wesleyv/Teensy-4.1-User-Configurable-Midi-to-CV/Midi to CV Schem and Production/Teensy 4.1 User Configurable Midi to CV.pdf

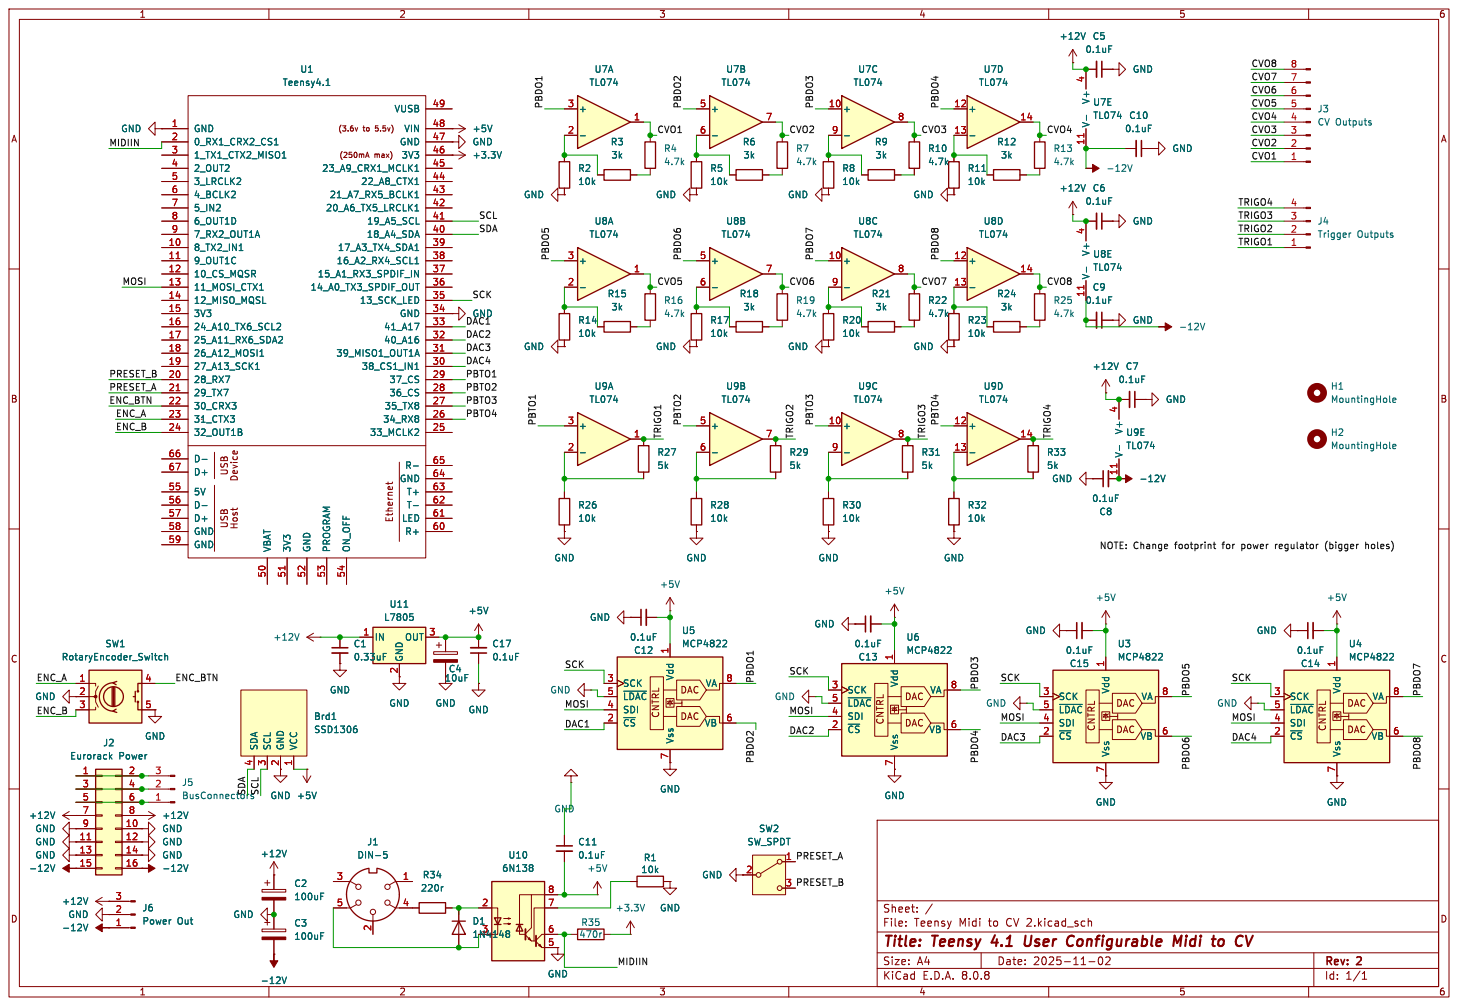
[picture p4: page 1]

1 ~{CS} 2 SCK 3 SDI 4 ~{LDAC} 5 VB 6 Vss 7 VA 8 U3 MCP4822 GND

1 ~{CS} 2 SCK 3 SDI 4 ~{LDAC} 5 VB 6 Vss 7 VA 8 U4 MCP4822 +

1 ~{CS} 2 SCK 3 SDI 4 ~{LDAC} 5 VB 6 Vss 7 VA 8 R30

1 ~{CS} 2 SCK 3 SDI 4 ~{LDAC} 5 VB 6 Vss 7 VA 8 U5 MCP4822 GND
0.1uFU10

1 ~{CS} 2 SCK 3 SDI 4 ~{LDAC} 5 VB 6 Vss 7 VA 8 GND

1 ~{CS} 2 SCK 3 SDI 4 ~{LDAC} 5 VB 6 Vss 7 VA 8 U6 MCP4822 C14
DAC Vdd

1 ~{CS} 2 SCK 3 SDI 4 ~{LDAC} 5 VB 6 Vss 7 VA 8 C14
