wesleyv/Teensy-4.1-User-Configurable-Midi-to-CV/Integrated Quad Slew Rate Limiter/Quad Slew Rate Limiter Schematic.pdf

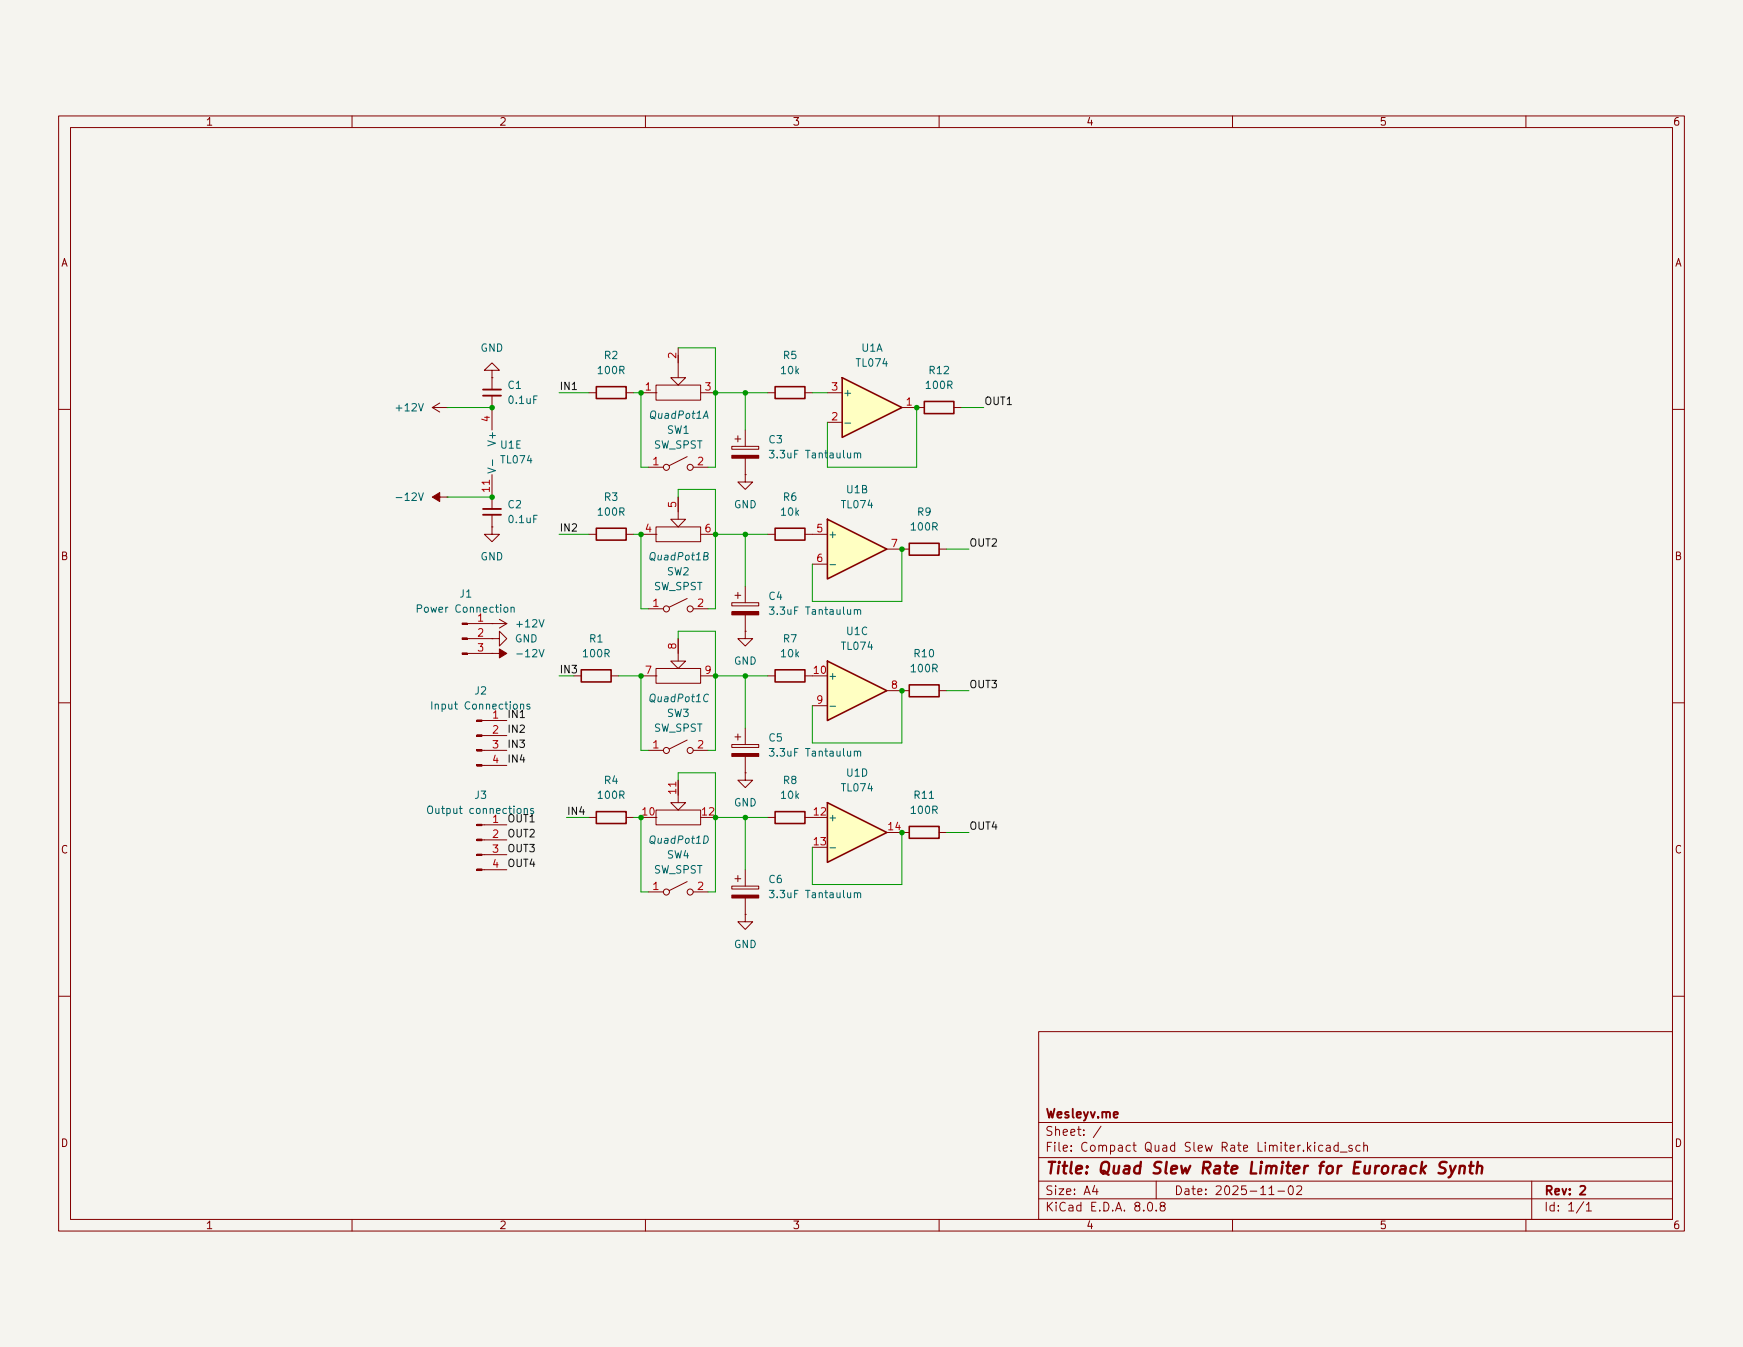
[picture p5: page 1]
